AlxReposit/Projeto_Magazine/README.md

# Projeto_Magazine
Arquivos e código referentes ao projeto Magazine da turma de Mecatrônica de 2023 - SENAI
