AlxReposit/Projeto_Magazine/Documentação/Diagramas/README.md

# Diagramas do Projeto #

Os diagramas estão divididos em:

- Diagramas Completos: descrevem o funcionamento dos processos com mais detalhes;
- Diagramas para Apresentação: descrevem o funcionamento dos processos de forma mais simplificada, usados na apresentação;
- Diagrama Elétrico: descreve as ligações elétricas utilizadas entre os componentes.
