AlxReposit/Projeto_Magazine/Documentação/Diagramas/Diagrama Elétrico.pdf

### Fonte de Alimentação

0V | 12V

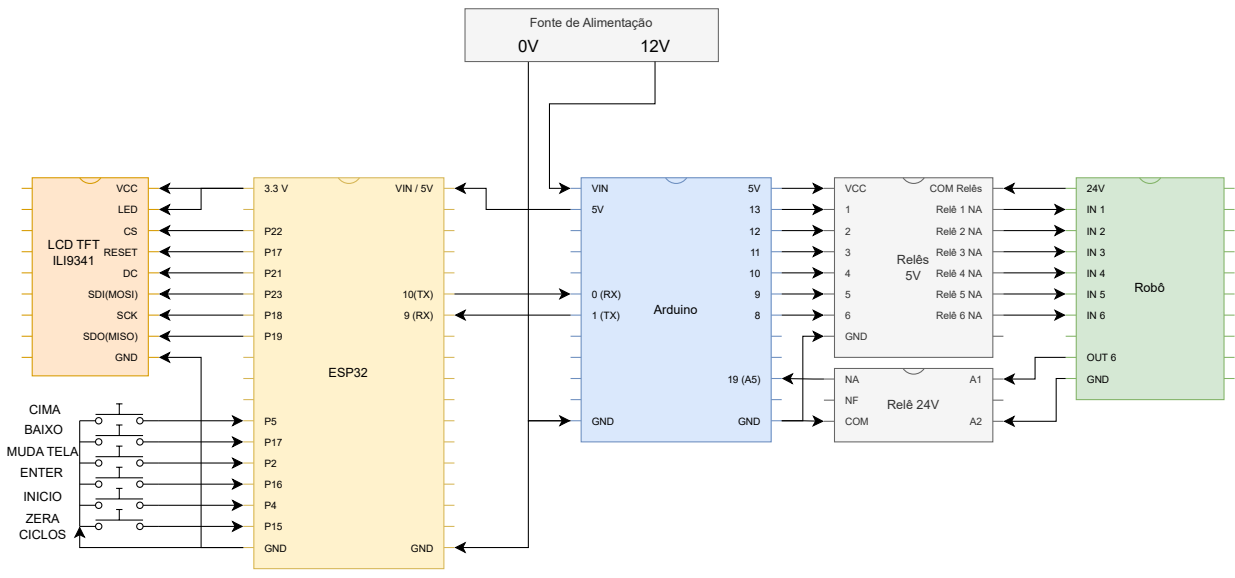
[picture p9: page 1]
