AlxReposit/Projeto_Magazine/Documentação/Diagramas/Diagramas Completos da Magazine.pdf

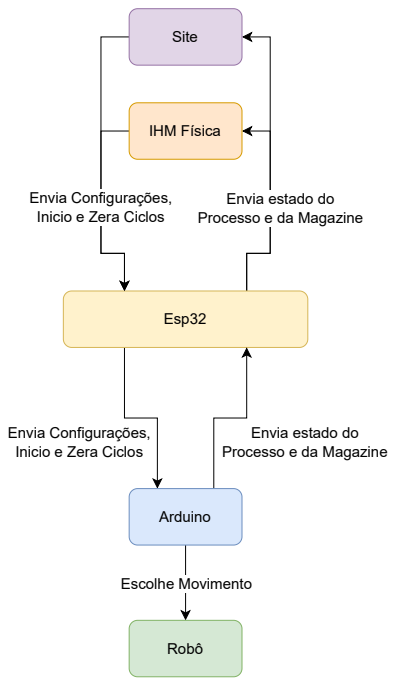
[picture p10: page 1]
Esp32; Escolhe Movimento; Arduino; Robô; IHM Física; Site

Envia Configurações,
Inicio e Zera Ciclos

Envia estado do
Processo e da Magazine

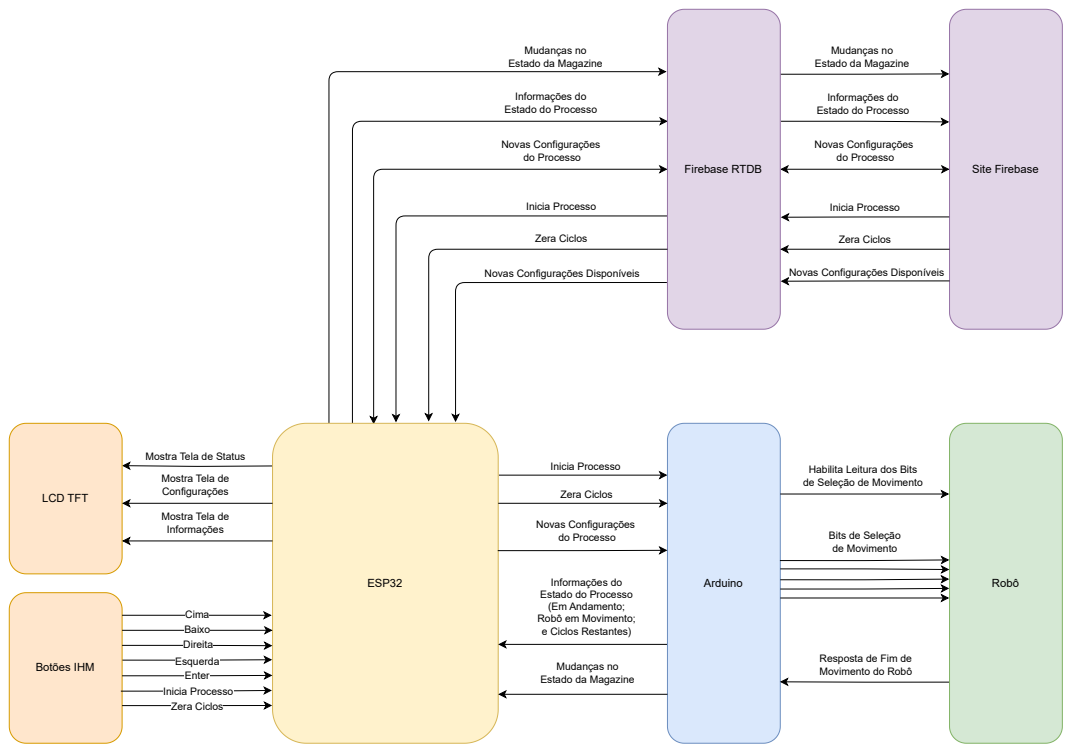
[picture p11: page 2]
Inicia Processo; Novas Configurações do Processo; ESP32; Informações do; Arduino; Robô; Firebase RTDB; Site Firebase; Zera Ciclos; LCD TFT; Botões IHM; Cima Baixo Direita Esquerda Enter Inicia Processo Zera Ciclos

Mudanças no
Estado da Magazine

Informações do
Estado do Processo

Novas Configurações Disponíveis

Mostra Tela de Status
Mostra Tela de
Configurações

Habilita Leitura dos Bits
de Seleção de Movimento

Informações

Bits de Seleção
de Movimento

(Em Andamento;
Robô em Movimento;
e Ciclos Restantes)

Resposta de Fim de
Movimento do Robô

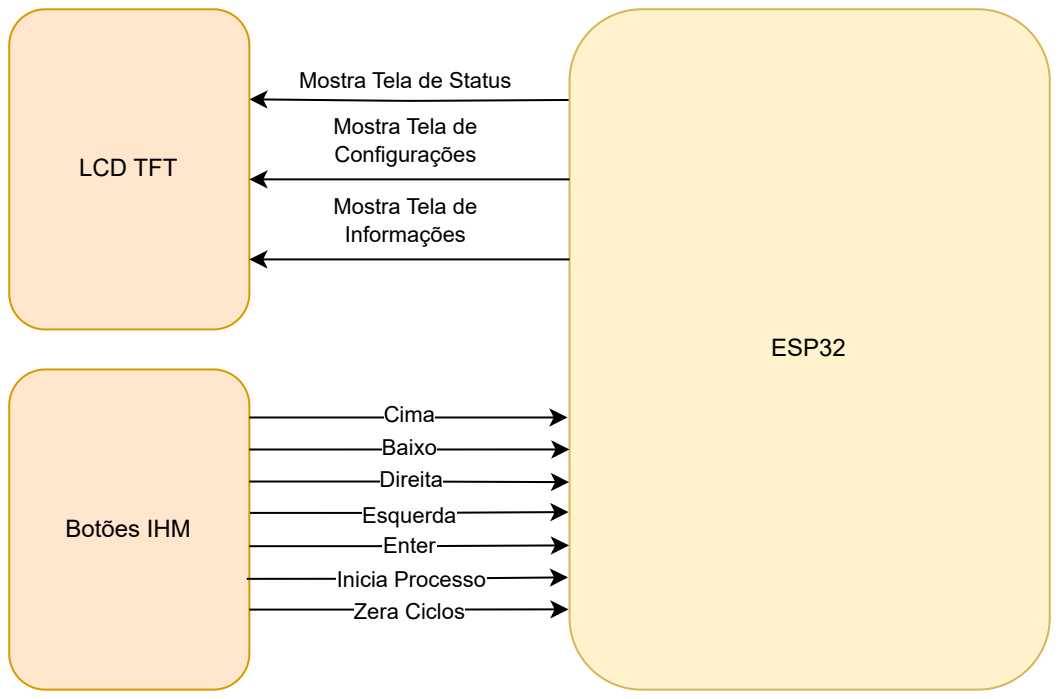
[picture p12: page 3]
ESP32; LCD TFT; Botões IHM; Cima Baixo Direita Esquerda Enter Inicia Processo Zera Ciclos

Mostra Tela de Status
Mostra Tela de
Configurações

Informações

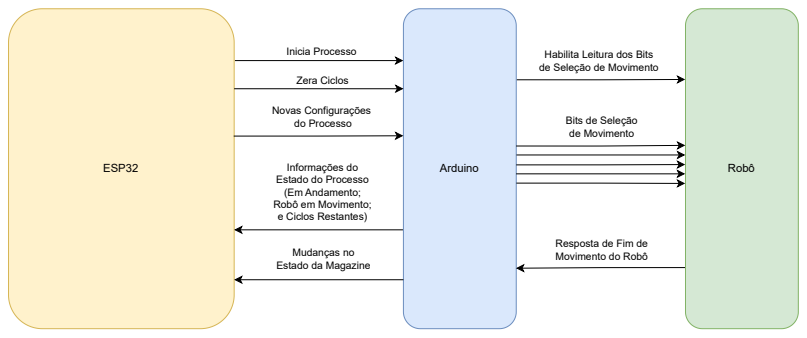
[picture p13: page 4]
Inicia Processo; ESP32; Informações do; Arduino; Robô; Zera Ciclos; Novas Configurações do Processo

Habilita Leitura dos Bits
de Seleção de Movimento

Bits de Seleção
de Movimento

Estado do Processo
(Em Andamento;
Robô em Movimento;
e Ciclos Restantes)

Resposta de Fim de
Movimento do Robô

Mudanças no
Estado da Magazine

# Setorização Retirar Peças da Magazine

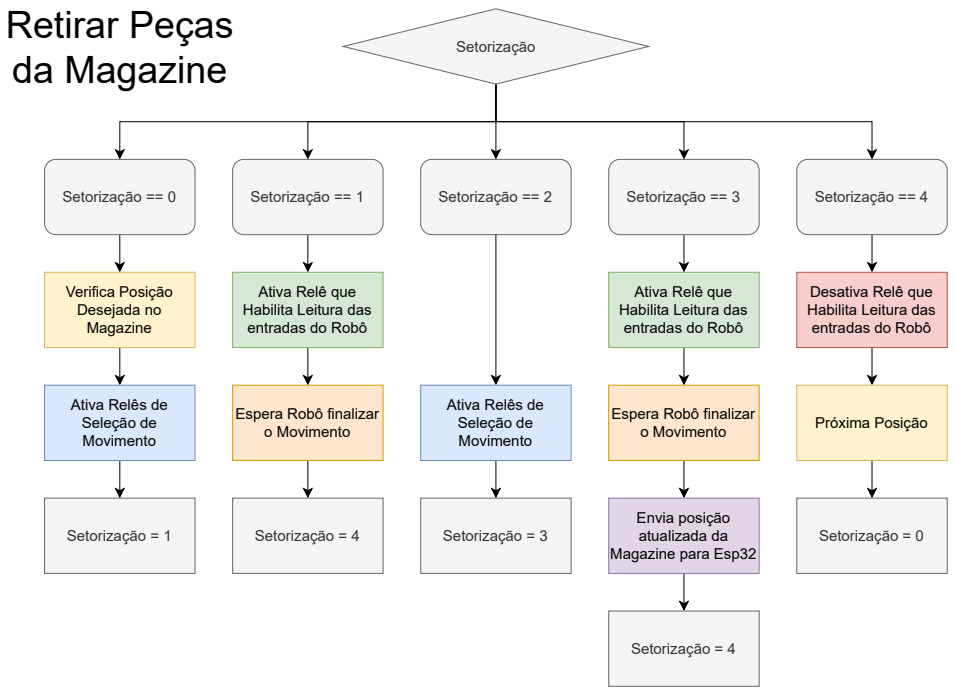
[picture p14: page 5]
Setorização == 0; Setorização == 1; Setorização == 2; Setorização == 3; Setorização == 4; Verifica Posição Desejada no Magazine; Setorização = 1; Envia posição atualizada da Magazine para Esp32; Setorização = 4; Setorização = 3; Próxima Posição; Setorização = 0

Ativa Relê que
Habilita Leitura das
entradas do Robô

Desativa Relê que

Ativa Relês de
Seleção de
Movimento

Espera Robô finalizar
o Movimento

# Setorização Colocar Peças Na Magazine

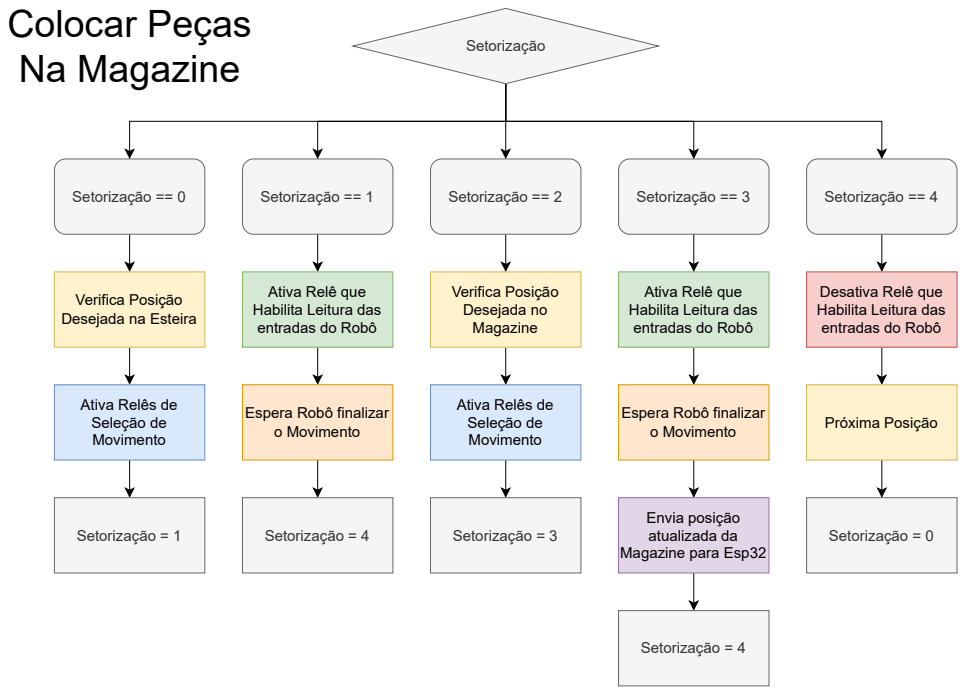
[picture p15: page 6]
Setorização == 0; Setorização == 1; Setorização == 2; Setorização == 3; Setorização == 4; Setorização = 1; Envia posição atualizada da Magazine para Esp32; Setorização = 4; Verifica Posição Desejada no Magazine; Setorização = 3; Próxima Posição; Setorização = 0

Ativa Relê que
Habilita Leitura das
entradas do Robô

Desativa Relê que

Verifica Posição
Desejada na Esteira

Ativa Relês de
Seleção de
Movimento

Espera Robô finalizar
o Movimento

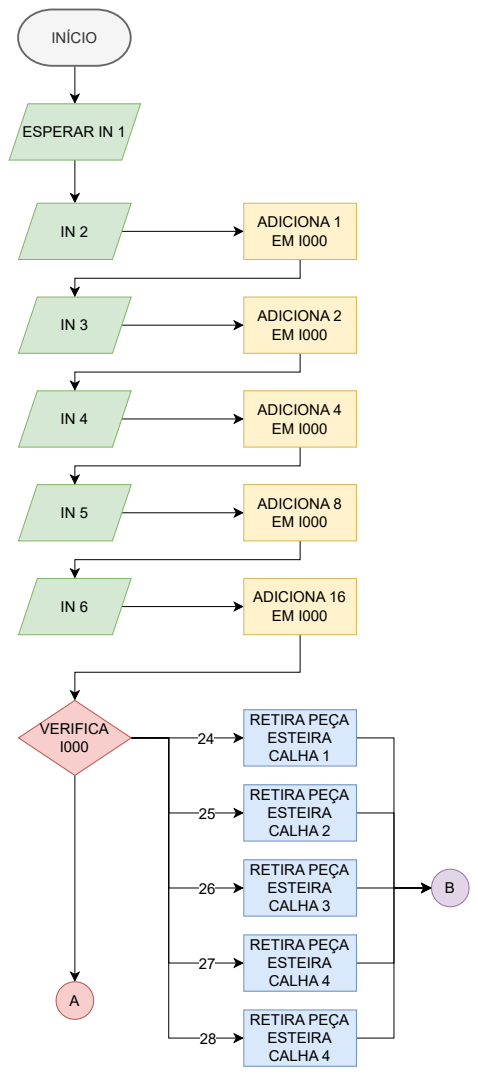
[picture p16: page 7]
INÍCIO; ESPERAR IN 1; VERIFICA I000; ADICIONA 1 EM I000; ADICIONA 2 EM I000; ADICIONA 8 EM I000; ADICIONA 16 EM I000; RETIRA PEÇA ESTEIRA CALHA 1; RETIRA PEÇA ESTEIRA CALHA 2; RETIRA PEÇA ESTEIRA CALHA 3; RETIRA PEÇA ESTEIRA CALHA 4; ADICIONA 4 EM I000

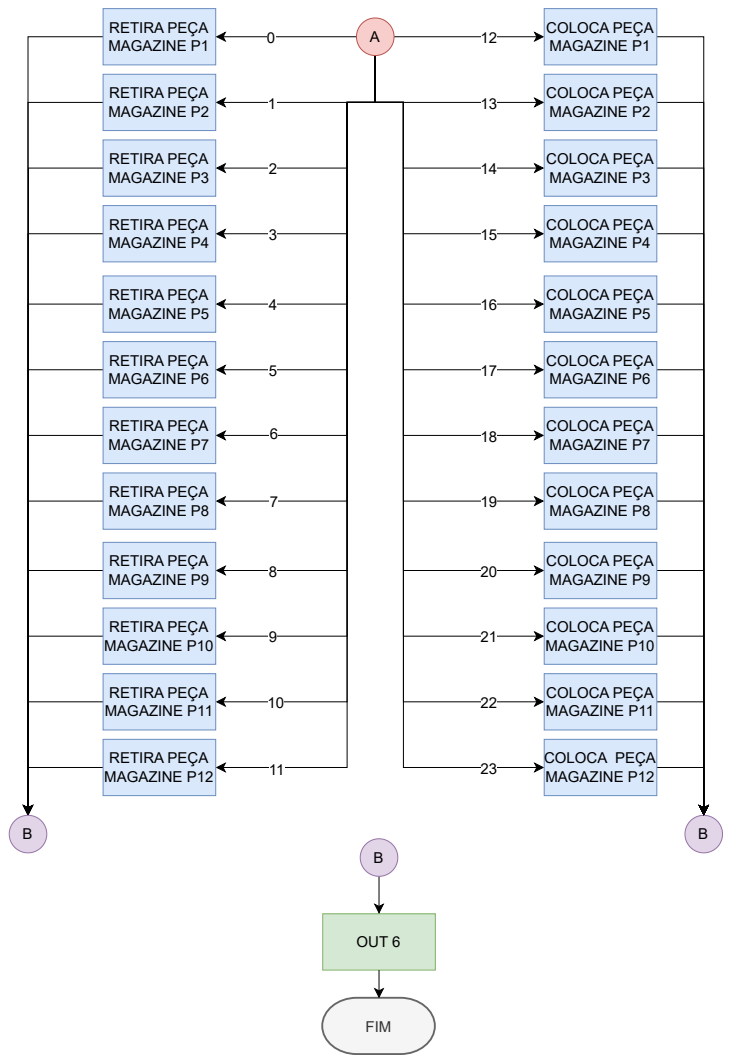
[picture p17: page 8]

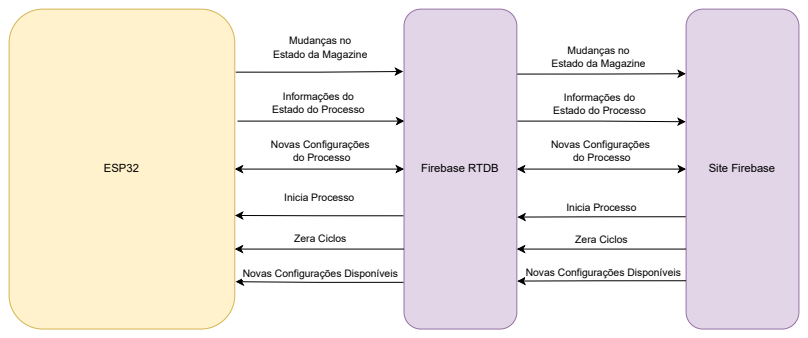
[picture p18: page 9]
Novas Configurações do Processo; ESP32; Inicia Processo; Firebase RTDB; Site Firebase; Zera Ciclos

Mudanças no
Estado da Magazine

Informações do
Estado do Processo

Novas Configurações Disponíveis

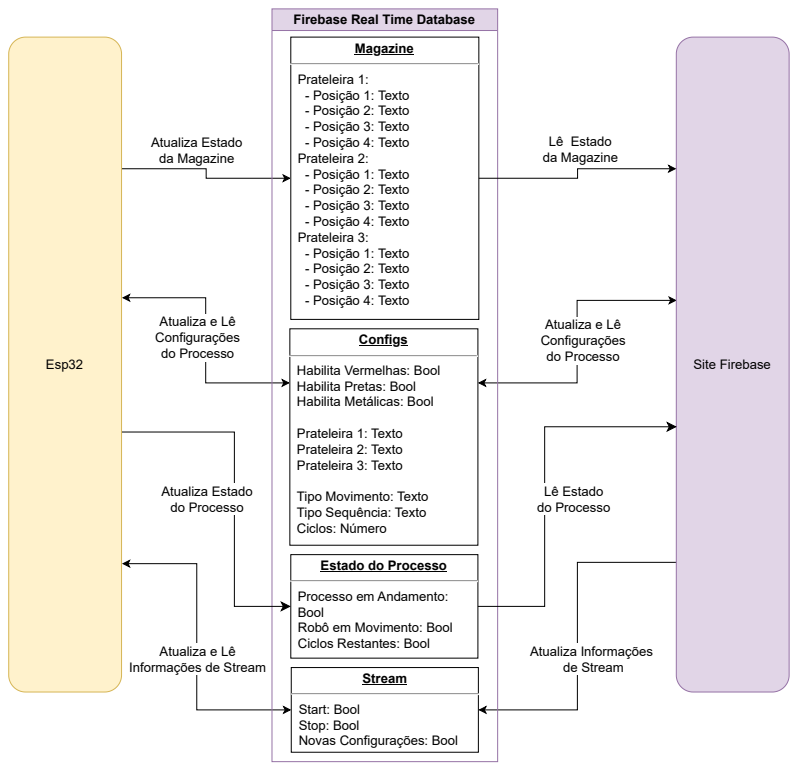
[picture p19: page 10]
Atualiza e Lê Configurações do Processo; Atualiza Estado da Magazine; Esp32; Site Firebase; Magazine; Prateleira 1: - Posição 1: Texto - Posição 2: Texto - Posição 3: Texto - Posição 4: Texto Prateleira 2: - Posição 1: Texto - Posição 2: Texto - Posição 3: Texto - Posição 4: Texto Prateleira 3: - Posição 1: Texto - Posição 2: Texto - Posição 3: Texto - Posição 4: Texto; Configs; Prateleira 1: Texto Prateleira 2: Texto Prateleira 3: Texto; Stream; Lê Estado da Magazine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

Firebase Real Time Database

Habilita Vermelhas: Bool
Habilita Pretas: Bool
Habilita Metálicas: Bool

Tipo Movimento: Texto
Tipo Sequência: Texto
Ciclos: Número

Estado do Processo

Processo em Andamento:
Bool
Robô em Movimento: Bool
Ciclos Restantes: Bool

Atualiza e Lê
Informações de Stream

Start: Bool
Stop: Bool
Novas Configurações: Bool
