AlxReposit/Projeto_Magazine/Documentação/Diagramas/Diagramas para Apresentação.pdf

Esp32; Escolhe Movimento; Arduino; Robô; IHM Física; Site

Envia Configurações,
Inicio e Zera Ciclos

Envia estado do
Processo e da Magazine

ESP32; LCD TFT; Botões IHM; Cima Baixo Direita Esquerda Enter Inicia Processo Zera Ciclos

Mostra Tela de Status
Mostra Tela de
Configurações

Informações

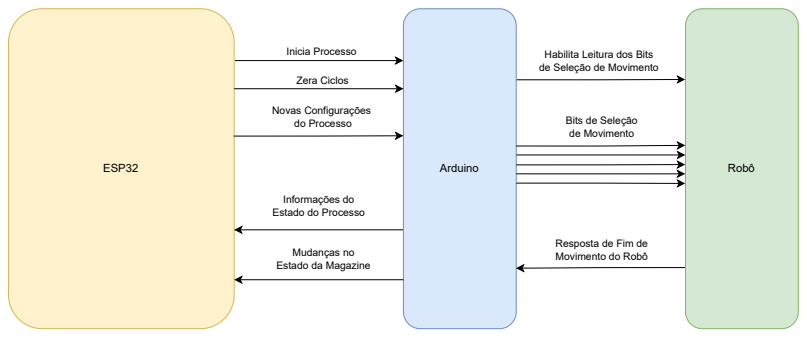
[picture p20: page 3]
Inicia Processo; ESP32; Arduino; Robô; Zera Ciclos; Novas Configurações do Processo

Habilita Leitura dos Bits
de Seleção de Movimento

Bits de Seleção
de Movimento

Informações do
Estado do Processo

Resposta de Fim de
Movimento do Robô

Mudanças no
Estado da Magazine

# Setorização Retirar Peças da Magazine

Setorização == 0; Setorização == 1; Setorização == 2; Setorização == 3; Setorização == 4; Verifica Posição Desejada no Magazine; Setorização = 1; Envia posição atualizada da Magazine para Esp32; Setorização = 4; Setorização = 3; Próxima Posição; Setorização = 0

Ativa Relê que
Habilita Leitura das
entradas do Robô

Desativa Relê que

Ativa Relês de
Seleção de
Movimento

Espera Robô finalizar
o Movimento

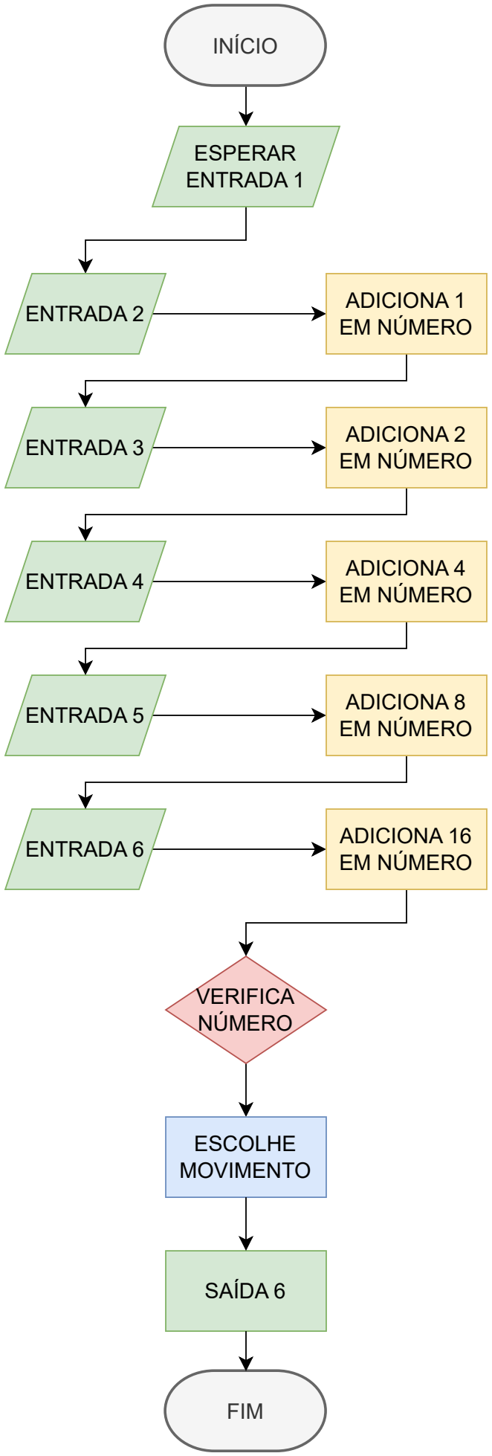
[picture p21: figure]
INÍCIO; FIM; ESPERAR ENTRADA 1; VERIFICA NÚMERO; SAÍDA 6; ENTRADA 2; ENTRADA 3; ENTRADA 4; ENTRADA 5; ENTRADA 6; ADICIONA 1 EM NÚMERO; ADICIONA 2 EM NÚMERO; ADICIONA 8 EM NÚMERO; ADICIONA 16 EM NÚMERO; ESCOLHE MOVIMENTO; ADICIONA 4 EM NÚMERO
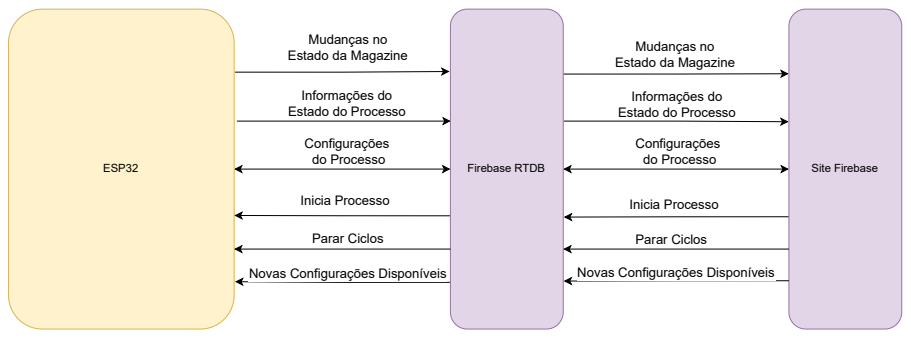
[picture p22: page 6]
Configurações do Processo; ESP32; Inicia Processo; Firebase RTDB; Site Firebase; Parar Ciclos

Mudanças no
Estado da Magazine

Informações do
Estado do Processo

Novas Configurações Disponíveis
