AlxReposit/Projeto_Magazine/Documentação/Diagramas/Fluxograma Magazine.pdf

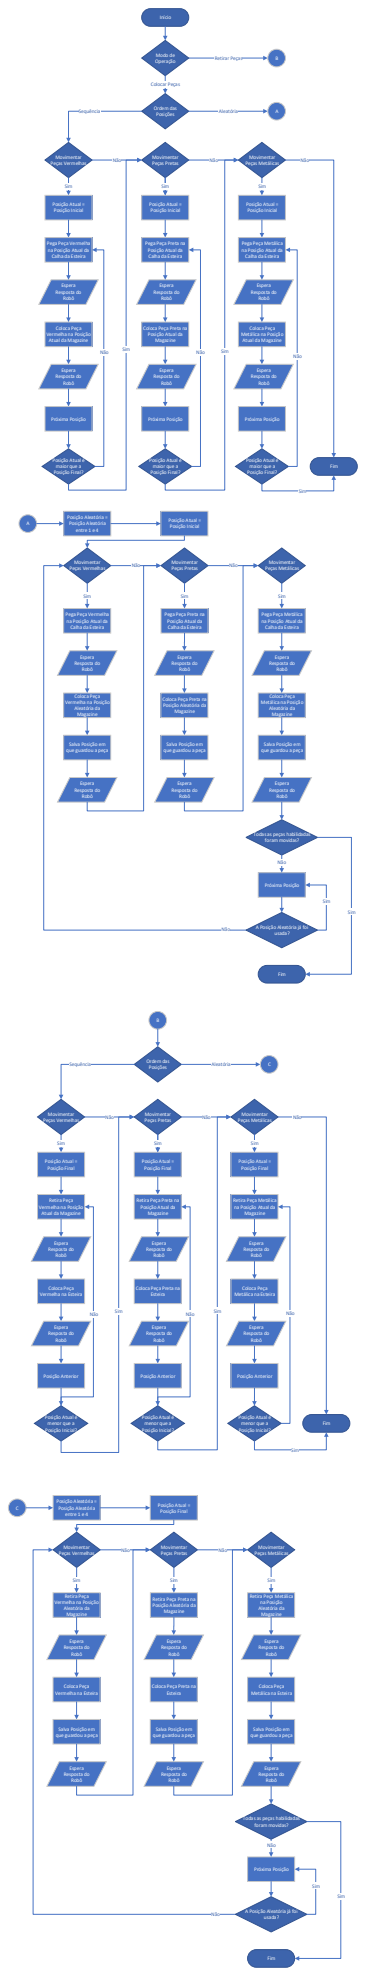
[picture p23: page 1]
Início; Modo de Operação; Ordem das Posições; Colocar Peças; Movimentar Peças Vermelhas; Sequência; Aleatória; Retirar Peças; Movimentar Peças Pretas; Movimentar; Peças Metálicas Não; Não; Sim; Posição Atual = Posição Inicial; Espera Resposta do Robô; Próxima Posição; Posição Atual é maior que a Posição Final?; Fim; Posição Aleatória = Posição Aleatória entre 1 e 4; Posição Atual = Posição Final; Posição Anterior; Posição Atual é menor que a Posição Inicial?; usada?; A Posição Aleatória já foi

Pega Peça Vermelha
na Posição Atual da
Calha da Esteira

Pega Peça Preta na
Posição Atual da

Pega Peça Metálica

Coloca Peça
Vermelha na Posição
Atual da Magazine

Coloca Peça Preta na
Magazine

Metálica na Posição

Aleatória da

Posição Aleatória da

Salva Posição em
que guardou a peça

Todas as peças habilidadas
foram movidas?

A Posição Aleatória já foi

Retira Peça

Retira Peça Preta na

Retira Peça Metálica

Vermelha na Esteira

Esteira

Metálica na Esteira

na Posição

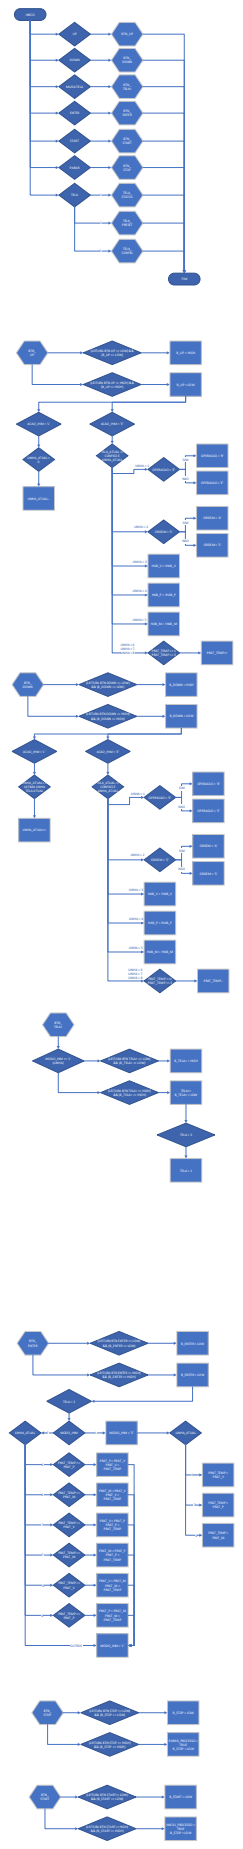
[picture p24: page 2]
INÍICO; DOWN; MUDA TELA; ENTER; BTN_UP; BTN_ DOWN; BTN_ TELA+; BTN_ ENTER; TELA; TELA_ STATUS; TELA_ CONFIG 3; BTN_ STOP; MODO_IHM == 'L' (LINHA); && (B_TELA+ == LOW); B_TELA+ = HIGH; TELA++ B_TELA+ = LOW; && (B_ENTER == LOW); B_ENTER = LOW; && (B_ENTER == HIGH); TELA = 2; MODO_IHM; PARAR; BTN_; STOP; && (B_STOP == LOW); B_STOP = LOW; PARAR_PROCESSO = TRUE B_STOP = LOW; TELA_ PRESET 2; && (B_DOWN == LOW); B_DOWN = HIGH; && (B_DOWN == HIGH); B_DOWN = LOW; ACAO_IHM = 'L'; ACAO_IHM = 'E'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

(LEITURA BTN UP == LOW) &&

(LEITURA BTN UP == HIGH) &&

(LEITURA BTN DOWN == LOW)

(LEITURA BTN DOWN == HIGH)

(LEITURA BTN TELA+ == LOW)

(LEITURA BTN TELA+ == HIGH)
&& (B_TELA+ == HIGH)

(LEITURA BTN ENTER == LOW)

(LEITURA BTN ENTER == HIGH)

(LEITURA BTN STOP == LOW)

(LEITURA BTN STOP == HIGH)
&& (B_STOP == HIGH)

(LEITURA BTN START== LOW)

(LEITURA BTN START== HIGH)
&& (B_START == HIGH)
