AlxReposit/Projeto_Magazine/(commit log)

2023-11-02 Arquivos Arduino
2023-11-02 Arquivos ESP32
2023-11-08 Update Projeto_Magazine_Esp32.ino
    Modificações em:
    - conectarFirebase(): adicionada função de Stream com Callback
    Adicionadas funções para Stream com e sem Callback
2023-11-09 Update txt
    links de referência
2023-11-09 Update and rename txt to Referências
    Links de referência usados na programação
2023-11-17 Update and rename txt to Referências
    Adicionadas referências utilizadas para a programação do Esp32
2023-12-11 Create Processo de Montagem e Programação
2023-12-11 Update Processo de Montagem e Programação
